Kreyl/TecoStLink/BOM.xls

Designator | Manufacturer Part Number | Quantity | Value | Case | Comment | Link
C1 | CC0603KRX5R5BB106 | 1 | 10u | CAP0603 | any capacitor 0603 EIA case, x5r or x7r isolator
C2 | CC0603KRX7R8BB225 | 1 | 2u2 | CAP0603 | any capacitor 0603 EIA case, x5r or x7r isolator
C3-C7, C12 | CC0603KRX7R9BB104 | 6 | 0.1u | CAP0603 | any capacitor 0603 EIA case, x5r or x7r or np0 isolator
C8, C9 | CC0603KRX7R8BB105 | 2 | 1u | CAP0603 | any capacitor 0603 EIA case, x5r or x7r isolator
C10, C11 | CC0603JRNPO9BN180 | 2 | 18pF | CAP0603 | any capacitor 0603 EIA case, np0 isolator
C13 | CC0603KRX7R9BB103 | 1 | 10n | CAP0603 | any capacitor 0603 EIA case, x5r or x7r or np0 isolator
D1, D2 | FYLS-0603PGC | 2 | GREEN | LED0603 | any blue LED 0603 EIA case, 100-180 mcd at If 20 mA and Vf 2.0-2.5V
D3 | FYLS-0603UBC | 1 | BLUE | LED0603 | any green LED 0603 EIA case, 100-180 mcd at If 20 mA and Vf 2.0-2.5V
D4 | PMEG2020AEA.115 | 1 | PMEG2020 | SOD323
D5-D8 | PESD3V3S1UB.115 | 4 | PESD3V3 | SOD323 | or PESD3V3U1UB.115 or ESD5Z3.3T1G
DA1 | LD1117S33TR | 1 | LD1117S33 | SOT223 | or LD1117S33CTR or TLV1117-33IDCYR or LM1117GS-3.3 or AMS1117-3.3
DD1 | STM32F103CBT6 | 1 | STM32F103CB | LQFP48 | or STM32F103CBT6TR
L1 | DLW21SN900SQ2L | 1 | DLW21SN900 | DLW21SN | or DLW21SN900SQ2
Q1, Q2 | BC848C | 2 | BC848 | SOT23-3 | or BC848B.215
Q3 | IRLML6402 | 1 | IRLML9303 | SOT23-3 | or IRLML6402TR or IRLML6402TRPBF or IRLML9303
R1, R3, R12, R13, R17, R22 | RC0603FR-0710KL | 6 | 10k | RES0603 | any resistor 0603 EIA case size 1% tolerance
R2 | RC0603FR-072RL | 1 | 2R0 | RES0603 | any resistor 0603 EIA case size 1% tolerance
R4 | RC0603FR-071K5L | 1 | 1k5 | RES0603 | any resistor 0603 EIA case size 1% tolerance
R5, R6, R18-R21 | RC0603FR-0722RL | 6 | 22R | RES0603 | any resistor 0603 EIA case size 1% tolerance
R7, R14 | RC0603FR-07100KL | 2 | 100k | RES0603 | any resistor 0603 EIA case size 1% tolerance
R8, R9 | RC0603FR-075K1L | 2 | 5.1k | RES0603 | any resistor 0603 EIA case size 1% tolerance
R10, R11, R15, R16 | RC0603FR-071KL | 4 | 1k | RES0603 | any resistor 0603 EIA case size 1% tolerance
R23 | RC0603FR-071ML | 1 | 1M | RES0603 | any resistor 0603 EIA case size 1% tolerance
SW1 | IT-1187U | 1 | BUTTON | BTN_4x4_SMD | or IT-1187-160GM-G (height 1.5mm)
VD1 | TPCM1213A-02SR | 1 | CM1213A−02SR | SOT143 | or CM1213A−02SR or SZCM1213A−02SR or D1213A-02SR-7TCT or PRTR5V0U2X.215
XL3 | DS1024-1x6R2 | 1 | CONN_6 | PBS-6R | or PBS-6R
XS1 | USB3.1 TYPE-C 16PF-015 | 1 | USBC 16PF-015 | USB-C_16pin_16PF-015
XTAL1 | SMD05032C2 | 1 | 8MHz | 0503x4-4 | any 8MHz crystal in a 4pin metal case 5.0mm x 3.2mm, tolerance 10ppm | https://www.quartz1.com/price/price.php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
