Kreyl/TecoStLink/3D/_TecoAsm.SLDASM

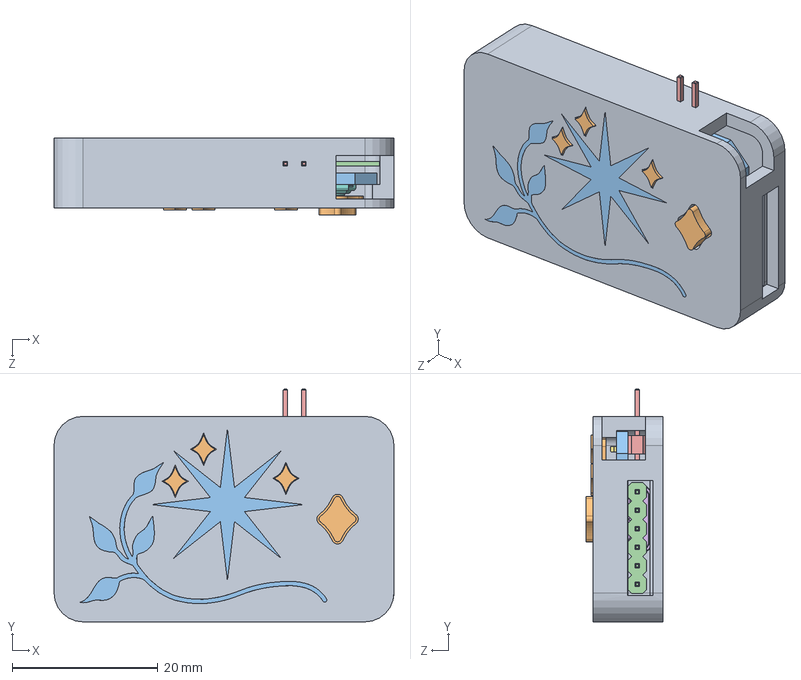
[picture p1: CAD file, 2024-11-14]
3D/_TecoAsm.SLDASM
46.7 x 32.0 x 10.6 mm
TecoTop
TecoBtn
TecoPCB
Conn_PLS6R
Conn_USB-C_16PF-015
LED_0603 x 3
Button_5x5x1.5 1187u
TecoCover
Stars
TecoLogo
