Kreyl/TecoStLink/3D/Additionally/Conn_USB-C_16PF-015.SLDPRT

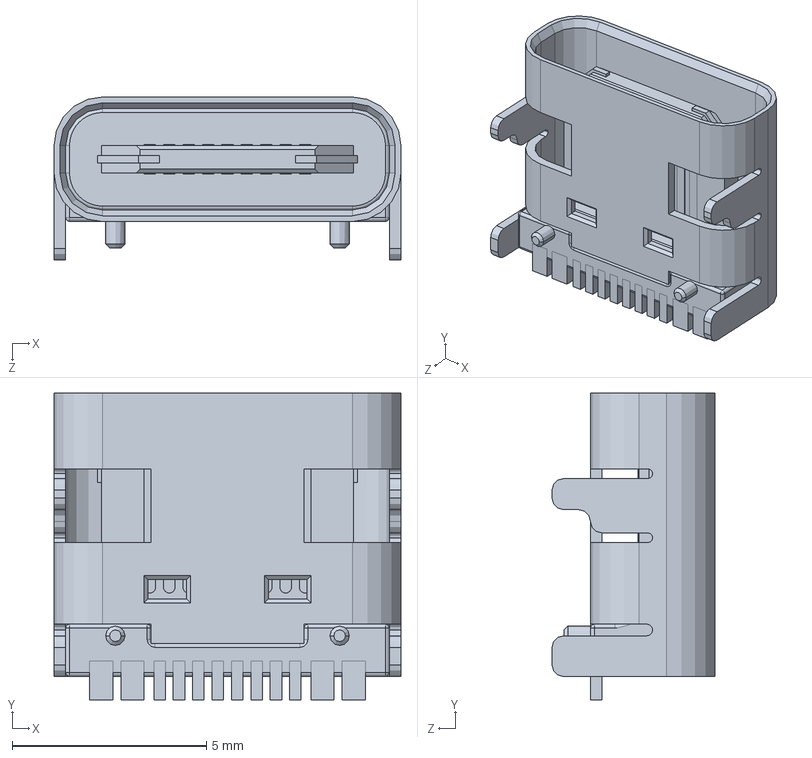
[picture p2: CAD file, 2024-11-14]
3D/Additionally/Conn_USB-C_16PF-015.SLDPRT
8.94 x 7.90 x 4.20 mm
