Kreyl/TecoStLink/3D/Additionally/TecoPCB.SLDPRT

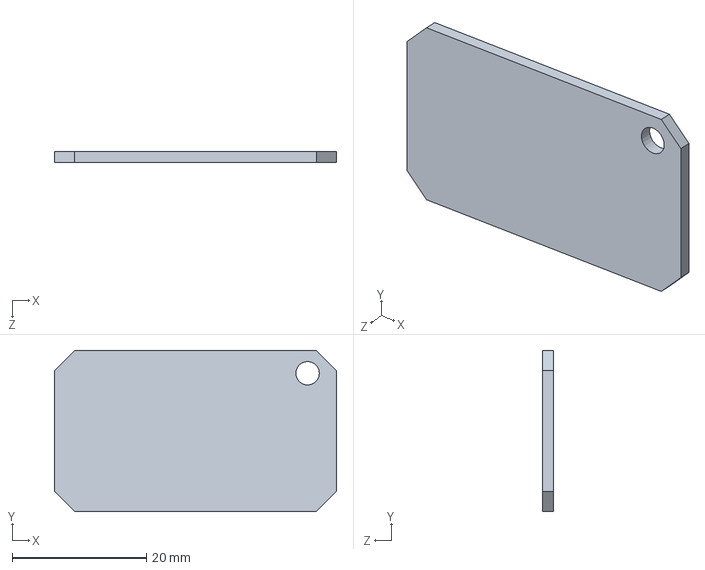
[picture p3: CAD file, 2024-11-13]
3D/Additionally/TecoPCB.SLDPRT
42.0 x 24.0 x 1.60 mm
