Kreyl/TecoStLink/3D/TecoTop.SLDPRT

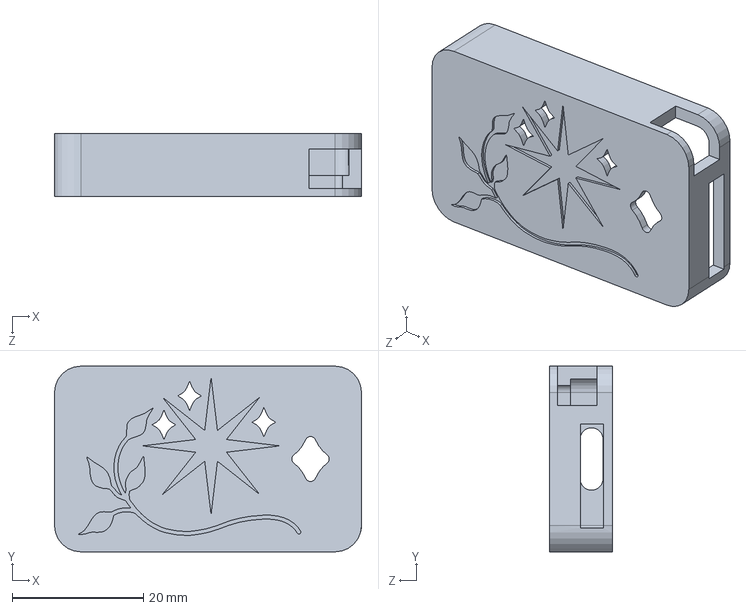
[picture p4: CAD file, 2024-11-14]
3D/TecoTop.SLDPRT
46.7 x 28.2 x 9.60 mm
