Kreyl/TecoStLink/3D/Additionally/Conn_PLS6R.SLDPRT

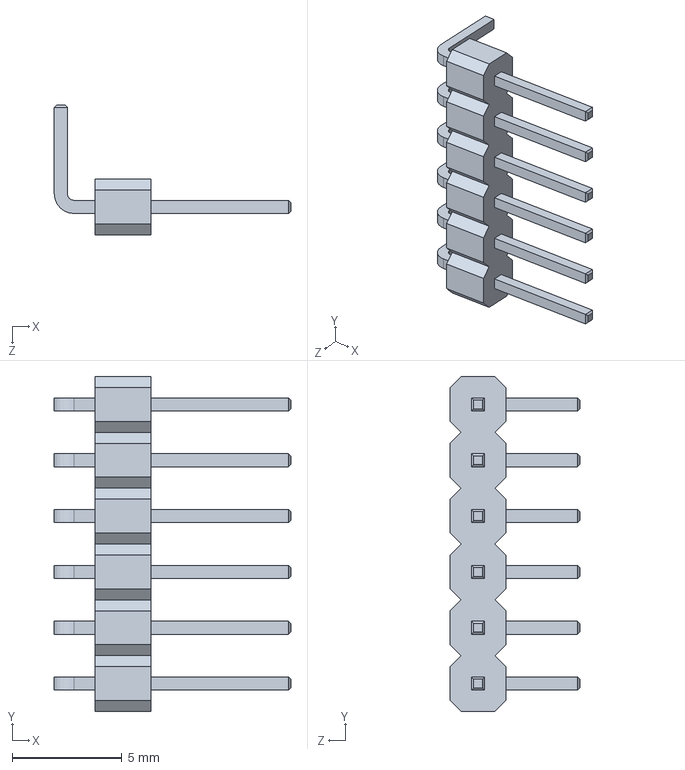
[picture p5: CAD file, 2024-11-13]
3D/Additionally/Conn_PLS6R.SLDPRT
10.8 x 15.2 x 5.90 mm
