Kreyl/TecoStLink/3D/Stars.SLDPRT

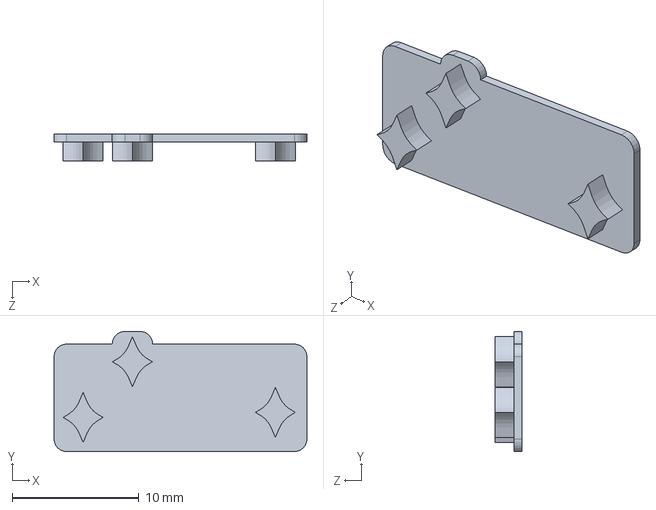
[picture p6: CAD file, 2024-11-13]
3D/Stars.SLDPRT
20.0 x 9.50 x 2.10 mm
