Kreyl/TecoStLink/3D/Additionally/LED_0603.SLDPRT

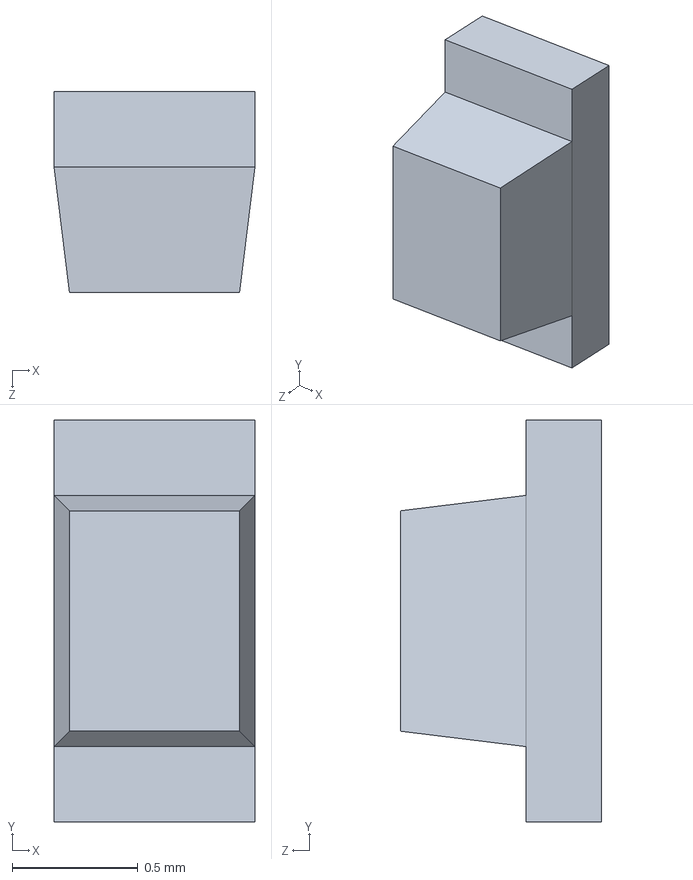
[picture p7: CAD file, 2024-11-13]
3D/Additionally/LED_0603.SLDPRT
0.8 x 1.60 x 0.8 mm
