Kreyl/TecoStLink/3D/TecoTop2.SLDPRT

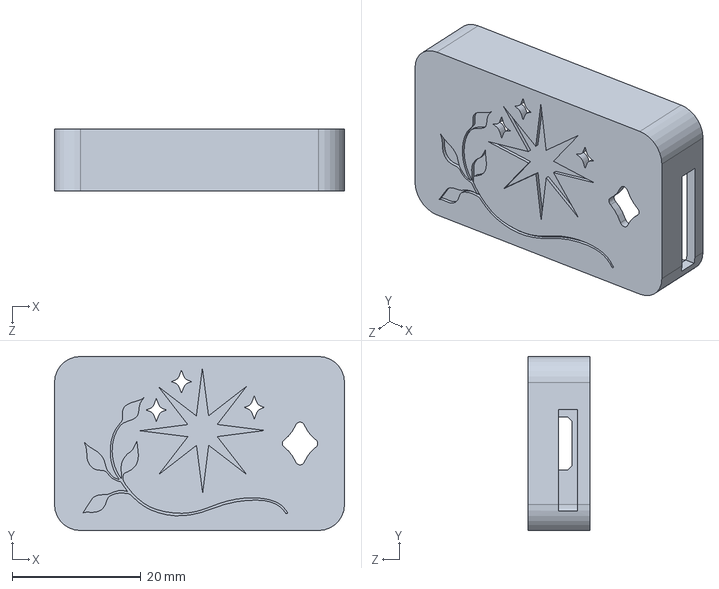
[picture p8: CAD file, 2024-11-13]
3D/TecoTop2.SLDPRT
45.0 x 27.0 x 9.60 mm
