Kreyl/TecoStLink/3D/Additionally/Button_5x5x1.5 1187u.SLDPRT

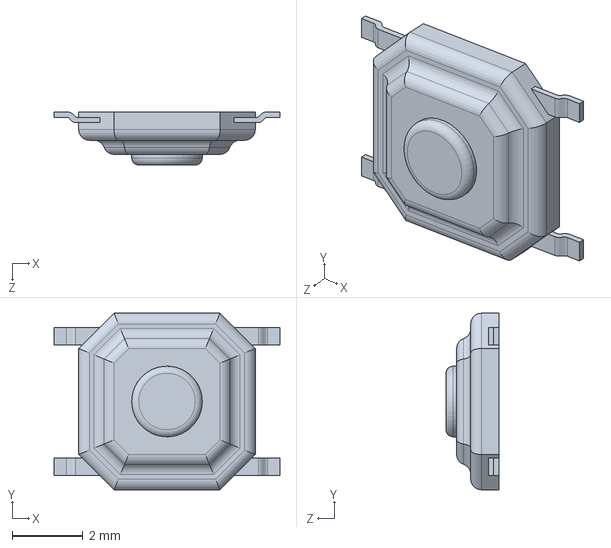
[picture p9: CAD file, 2024-11-13]
3D/Additionally/Button_5x5x1.5 1187u.SLDPRT
6.40 x 5.00 x 1.50 mm
