Kreyl/TecoStLink/3D/TecoLogo.SLDPRT

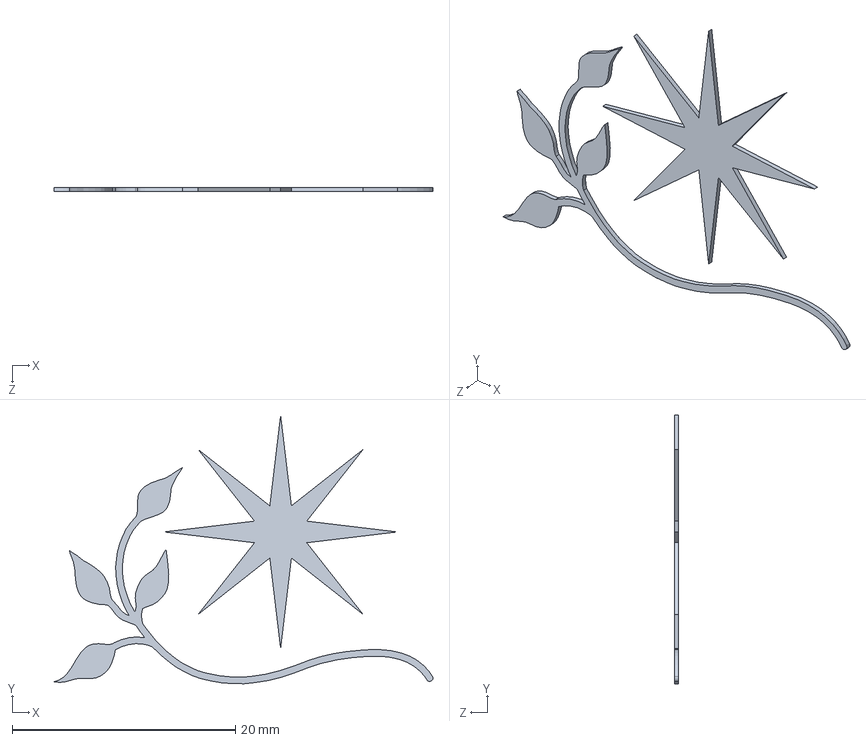
[picture p10: CAD file, 2024-11-13]
3D/TecoLogo.SLDPRT
34.0 x 24.1 x 0.4 mm
