Kreyl/TecoStLink/3D/Additionally/Conn_PLS2R.SLDPRT

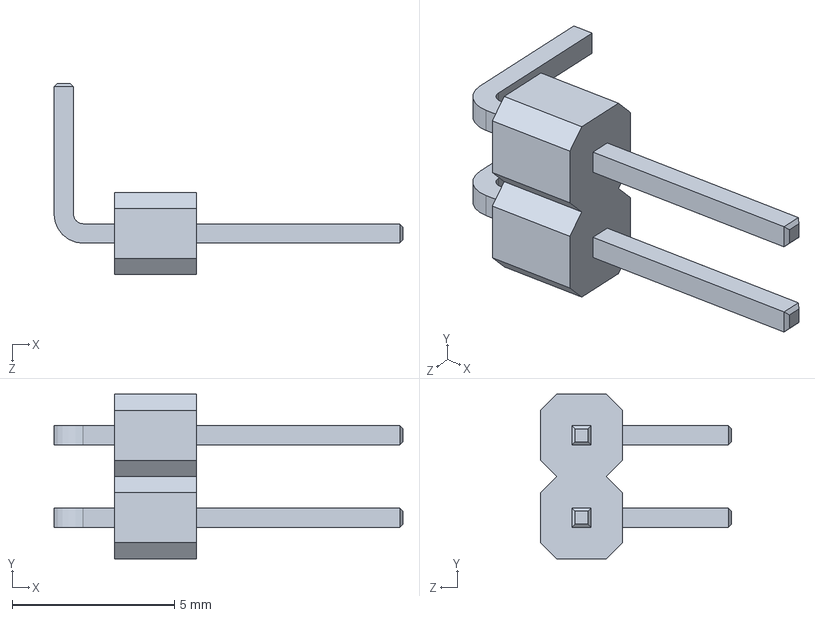
[picture p11: CAD file, 2024-11-13]
3D/Additionally/Conn_PLS2R.SLDPRT
10.8 x 5.08 x 5.90 mm
