Kreyl/TecoStLink/3D/TecoBtn.SLDPRT

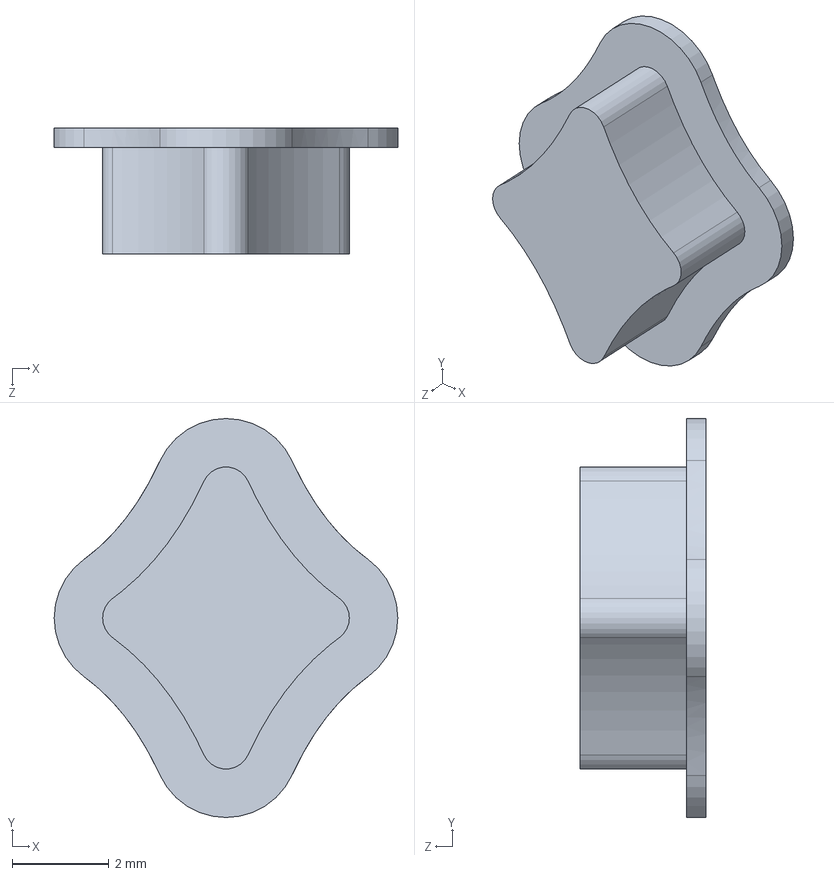
[picture p12: CAD file, 2024-11-13]
3D/TecoBtn.SLDPRT
7.09 x 8.24 x 2.60 mm
