Kreyl/TecoStLink/3D/TecoCover.SLDPRT

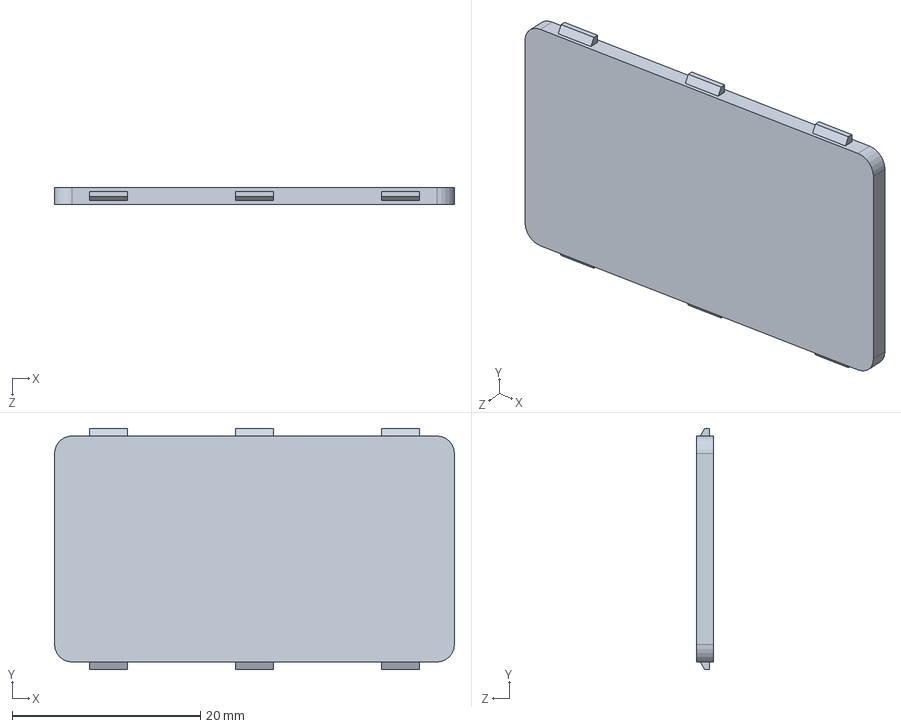
[picture p13: CAD file, 2024-11-13]
3D/TecoCover.SLDPRT
42.5 x 25.6 x 1.80 mm
