Kreyl/TecoStLink/Teco.pdf

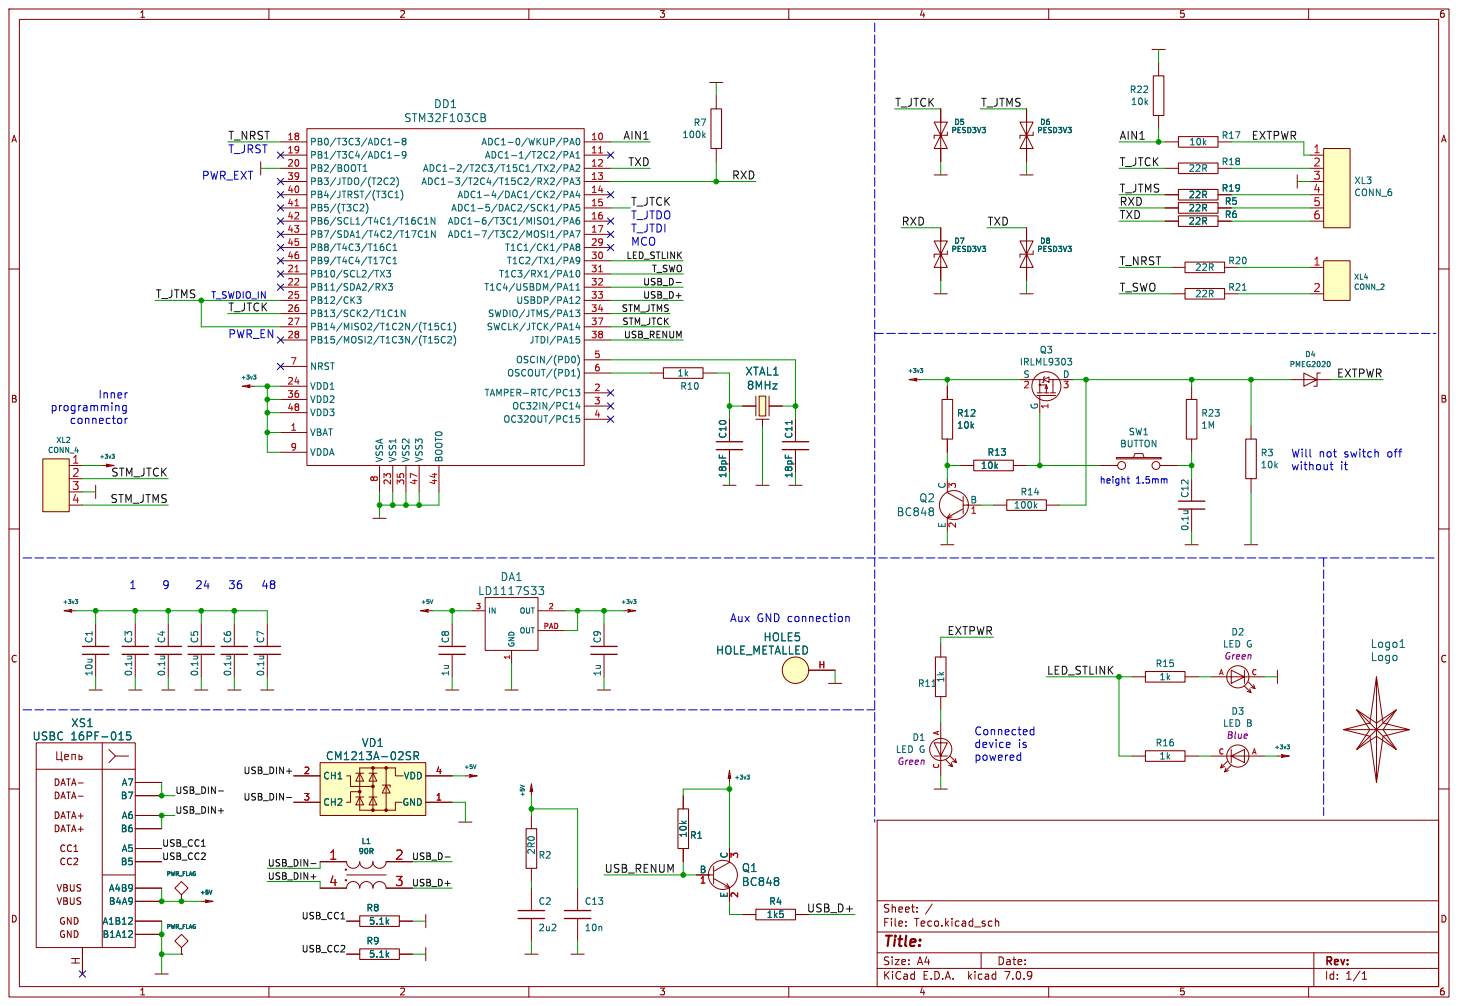
[picture p14: page 1]

þÿ&5?L CC1 CC2 DATA+ DATA+ DATA- DATA- GND GND

Id: 1/1 Title: File: Teco.kicad_sch Sheet: / GND
