Kreyl/TecoStLink/Teco.kicad_pcb

## KiCad design Teco.kicad_pcb (2024-11-14)

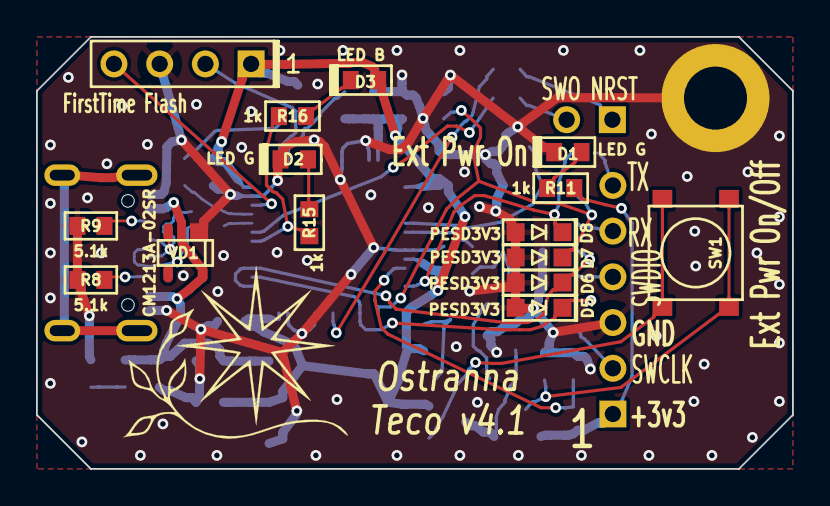
[picture p15: board Teco.kicad_pcb from above]

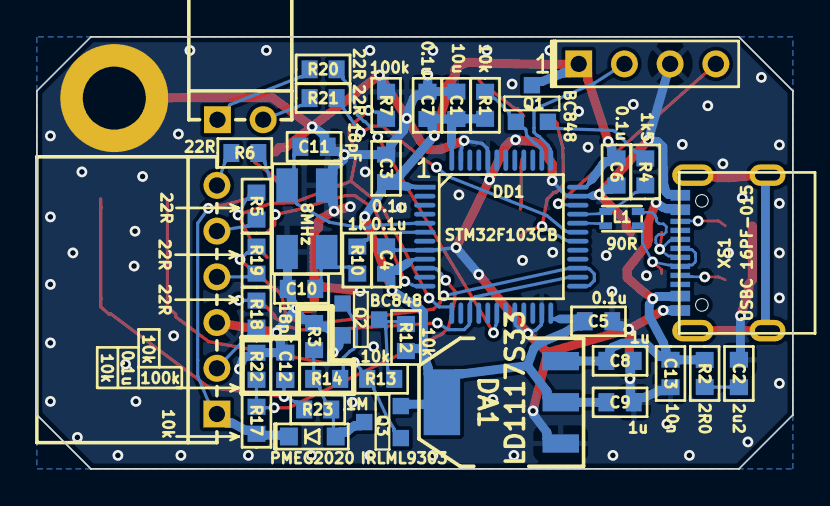
[picture p16: board Teco.kicad_pcb from below]

Board: 2 copper layers, 42.0 x 24.0 mm, 59 parts (42 on the bottom side), 40 nets.

Parts:
C1: 10u; CAP_0603
C2: 2u2; CAP_0603
C3, C4, C5, C6, C7, C12: 0.1u; CAP_0603
C8, C9: 1u; CAP_0603
C10, C11: 18pF; CAP_0603
C13: 10n; CAP_0603
D1, D2: LED G; LED_0603
D3: LED B; LED_0603
D4: PMEG2020; SOD323
D5, D6, D7, D8: PESD3V3; SOD323
DA1: LD1117S33; SOT223
DD1: STM32F103CB; LQFP48
HOLE5: HOLE_METALLED; Hole3_5_out6mm
L1: 90R; DLW21SN
Logo1: Logo; Ostranna_12d7_10d1
Q1, Q2: BC848; SOT23-3
Q3: IRLML9303; SOT23-3
R1, R3, R12, R13, R17, R22: 10k; RES_0603
R2: 2R0; RES_0603
R4: 1k5; RES_0603
R5, R6, R18, R19, R20, R21: 22R; RES_0603
R7, R14: 100k; RES_0603
R8, R9: 5.1k; RES0603
R10, R11, R15, R16: 1k; RES_0603
R23: 1M; RES_0603
SW1: BUTTON; BTN_4x4_SMD
VD1: CM1213A−02SR; SOT143
XL2: CONN_4; PLS-4
XL3: CONN_6; PBS-6R-MIRR
XL4: CONN_2; PBS-2R-MIRR
XS1: USBC 16PF-015; USB-C_16pin_16PF-015
XTAL1: 8MHz; 0503x4-4

Connections:
+3v3: C1.1, C3.1, C4.1, C5.1, C6.1, C7.1, C9.1, D3.A, DA1.2 (OUT), DA1.PAD (OUT), DD1.1 (VBAT), DD1.9 (VDDA), DD1.24 (VDD1), DD1.36 (VDD2), DD1.48 (VDD3), Q1.3 (C), Q3.2 (S), R1.2, R12.1, XL2.1
+5v: C8.1, C13.1, DA1.3 (IN), R2.1, VD1.4 (VDD), XS1.A4B9, XS1.B4A9
/AIN1: DD1.10 (ADC1-0/WKUP/PA0), R17.2, R22.1
/EXTPWR: D4.C, R11.2, R17.1, XL3.1
/LED_STLINK: DD1.30 (T1C2/TX1/PA9), R15.2, R16.2
/RXD: D7.C, DD1.13 (ADC1-3/T2C4/T15C2/RX2/PA3), R5.2, R7.1
/STM_JTCK: DD1.37 (SWCLK/JTCK/PA14), XL2.2 (PM)
/STM_JTMS: DD1.34 (SWDIO/JTMS/PA13), XL2.4
/TXD: D8.C, DD1.12 (ADC1-2/T2C3/T15C1/TX2/PA2), R6.2
/T_JTCK: D5.C, DD1.15 (ADC1-5/DAC2/SCK1/PA5), DD1.26 (PB13/SCK2/T1C1N), R18.2
/T_JTMS: D6.C, DD1.25 (PB12/CK3), DD1.27 (PB14/MISO2/T1C2N/(T15C1)), R19.2
/T_NRST: DD1.18 (PB0/T3C3/ADC1-8), R20.2
/T_SWO: DD1.31 (T1C3/RX1/PA10), R21.2
/USB_CC1: R8.2, XS1.A5
/USB_CC2: R9.2, XS1.B5
/USB_D+: DD1.33 (USBDP/PA12), L1.3, R4.1
/USB_D-: DD1.32 (T1C4/USBDM/PA11), L1.2
/USB_DIN+: L1.4, VD1.3 (CH2), XS1.A6, XS1.B6
/USB_DIN-: L1.1, VD1.2 (CH1), XS1.A7, XS1.B7
/USB_RENUM: DD1.38 (JTDI/PA15), Q1.1 (B), R1.1
GND: C1.2, C2.2, C3.2, C4.2, C5.2, C6.2, C7.2, C8.2, C9.2, C10.2, C11.2, C12.2, C13.2, D1.C, D2.C, D5.A, D6.A, D7.A, D8.A, DA1.1 (GND), DD1.8 (VSSA), DD1.20 (PB2/BOOT1), DD1.23 (VSS1), DD1.35 (VSS2), DD1.44 (BOOT0), DD1.47 (VSS3), HOLE5.H, Q2.2 (E), R3.2, R7.2, R8.1, R9.1, R22.2, VD1.1 (GND), XL2.3, XL3.3, XS1.A1B12, XS1.B1A12, XTAL1.H
unnamed: C2.1, R2.2
unnamed: C10.1, R10.1, XTAL1.1
unnamed: C12.1, R23.2, SW1.2
unnamed: D1.A, R11.1
unnamed: D2.A, R15.1
unnamed: D3.C, R16.1
unnamed: C11.1, DD1.5 (OSCIN/(PD0)), XTAL1.2
unnamed: DD1.6 (OSCOUT/(PD1)), R10.2
unnamed: Q1.2 (E), R4.2
unnamed: Q2.1 (B), R14.2
unnamed: Q2.3 (C), R12.2, R13.2
unnamed: D4.A, Q3.3 (D), R3.1, R14.1, R23.1
unnamed: Q3.1 (G), R13.1, SW1.1
unnamed: R5.1, XL3.5
unnamed: R6.1, XL3.6
unnamed: R18.1, XL3.2
unnamed: R19.1, XL3.4
unnamed: R20.1, XL4.1
unnamed: R21.1, XL4.2 (PM)
