Kreyl/TecoStLink/Firmware/F103Bmp/include/version.h

/*
 * version.h
 *
 *  Created on: 28 нояб. 2023 г.
 *      Author: laurelindo
 */

#ifndef INCLUDE_VERSION_H_
#define INCLUDE_VERSION_H_

#define FIRMWARE_VERSION "v1.10.0-237-g39cb6d61"



#endif /* INCLUDE_VERSION_H_ */
