Kreyl/TecoStLink/(commit log)

2017-04-27 + Sch done, PCB started
    [Teco.kicad_pcb, Teco.sch]
2017-04-27 Sch updated Layout done
    [Teco.kicad_pcb, Teco.sch]
2017-04-28 Sent to production
    [Teco.kicad_pcb, Teco.sch]
2017-05-12 + R to discharge pwr line
    [Teco.sch]
2019-04-22 + v3 Sent to factory
    [Teco.kicad_pcb, Teco.sch]
2019-04-22 + V2
    [Teco.csv, Teco.kicad_pcb]
2019-04-22 v3.1: + Pull-up on RX + legend
    [Teco.kicad_pcb, Teco.sch]
2020-05-28 + Readme + St-Link upgrade
    [Teco.kicad_pcb]
2020-05-29 + Teco v4 + USB renum returned!
    [Teco.kicad_pcb, Teco.kicad_sch]
2024-11-13 switch to KiCAD 7
    [Teco.kicad_pcb, Teco.kicad_sch, Teco.sch]
2024-11-13 + 3D case
    [Button 4x4 1187u.SLDPRT, Conn_Molex 105017-0001.sldprt, Conn_PLS2R.SLDPRT, Conn_PLS6R.SLDPRT, LED_0603.SLDPRT, Stars.SLDPRT, TecoBtn.SLDPRT, TecoCover.SLDPRT]
2024-11-13 PCB thickness 1.6mm
    [TecoPCB.SLDPRT, _TecoAsm.SLDASM]
2024-11-14 button rename
    [Button_5x5x1.5 1187u.SLDPRT, _TecoAsm.SLDASM]
2024-11-14 USB-C connector installed, ESD USB protection added, new BOM created
    [BOM.xls, Teco.csv, Teco.kicad_pcb, Teco.kicad_sch]
2024-11-14 upgrade complete
    [Conn_Molex 105017-0001.sldprt, Conn_USB-C_16PF-015.SLDPRT, Teco.kicad_pcb, Teco.kicad_sch, TecoTop.SLDPRT, _TecoAsm.SLDASM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]
